MichaelBentleyOh/RCS_2023_winter_project/modeling/stl/Arm_Upper(15).stl

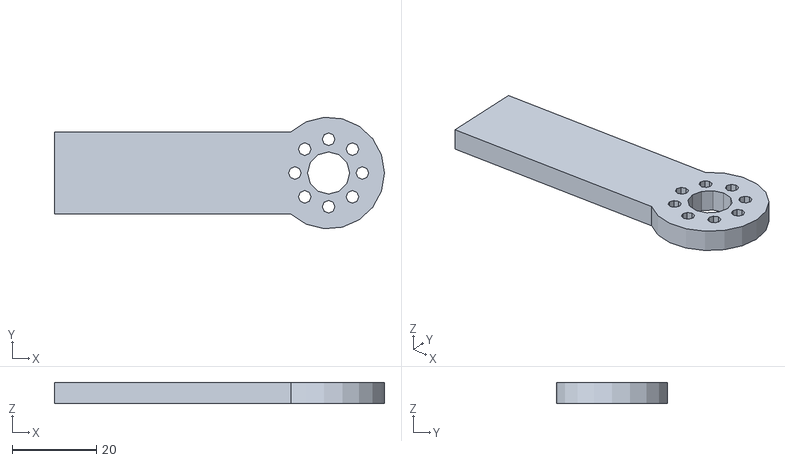
[picture p42: CAD file, 2024-02-15]
modeling/stl/Arm_Upper(15).stl
78.2 x 26.4 x 5.00
