MichaelBentleyOh/RCS_2023_winter_project/modeling/stl/Cap(20).stl

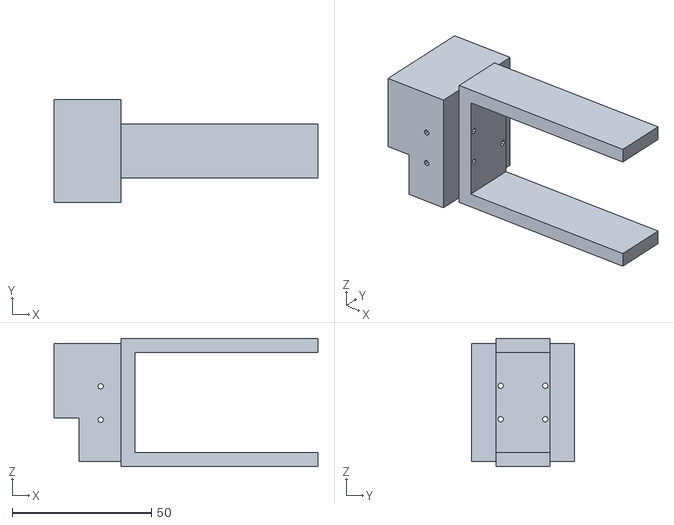
[picture p43: CAD file, 2024-02-15]
modeling/stl/Cap(20).stl
94.8 x 36.9 x 46.0
