MichaelBentleyOh/RCS_2023_winter_project/modeling/stl/2ND_TIGHT.stl

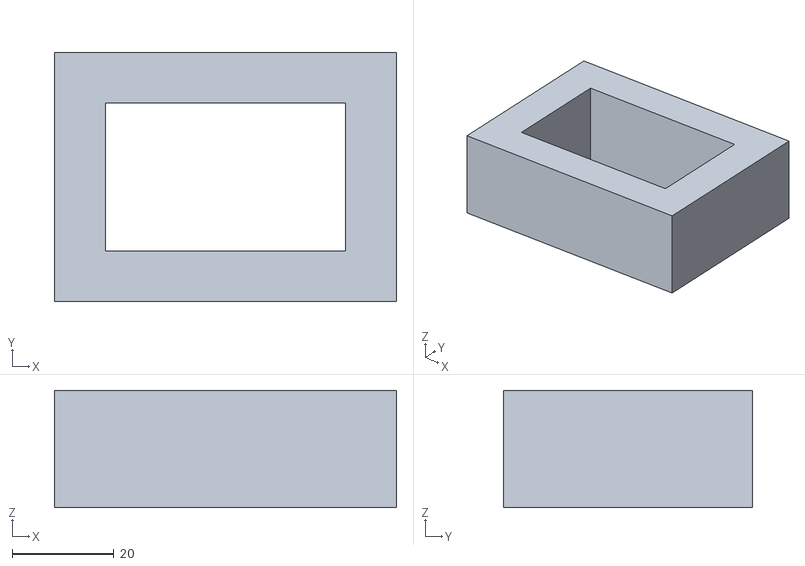
[picture p44: CAD file, 2024-02-15]
modeling/stl/2ND_TIGHT.stl
67.2 x 49.0 x 23.0
