MichaelBentleyOh/RCS_2023_winter_project/modeling/stl/2ND_SHORT_POLE(M2)X2.stl

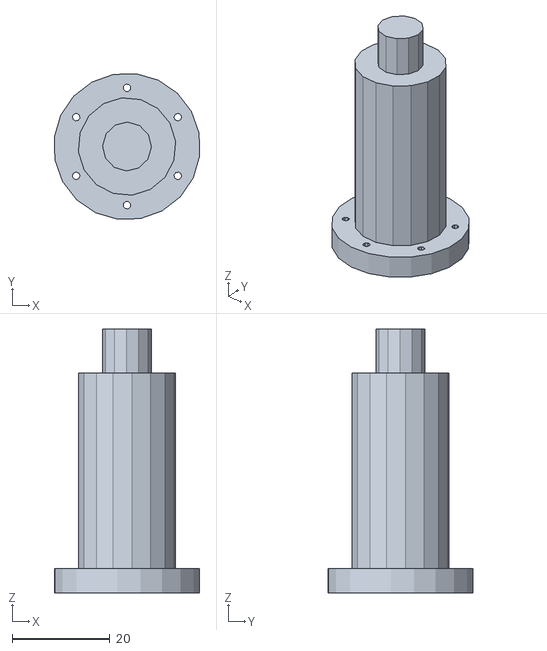
[picture p45: CAD file, 2024-02-15]
modeling/stl/2ND_SHORT_POLE(M2)X2.stl
29.8 x 29.8 x 54.0
