MichaelBentleyOh/RCS_2023_winter_project/modeling/stl/Cap(15).stl

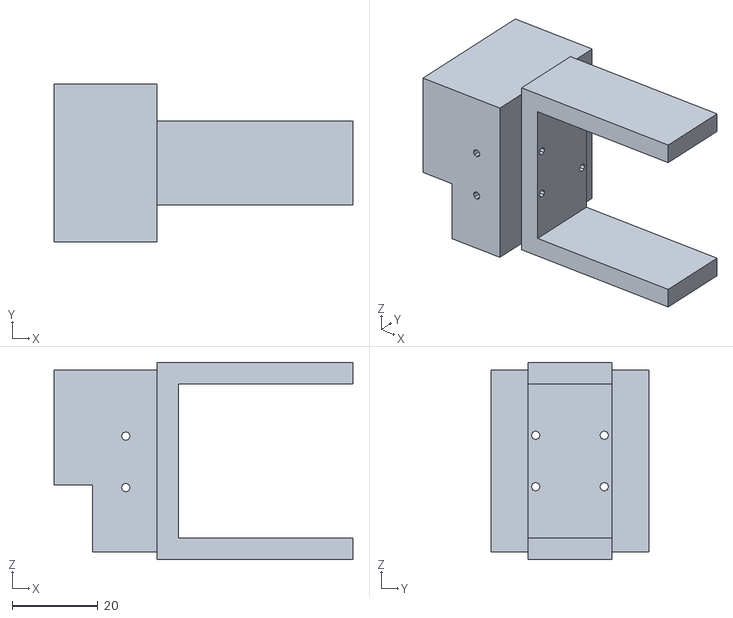
[picture p46: CAD file, 2024-02-15]
modeling/stl/Cap(15).stl
69.8 x 36.9 x 46.0
