MichaelBentleyOh/RCS_2023_winter_project/modeling/stl/2ND_LONG_POLE(M2).stl

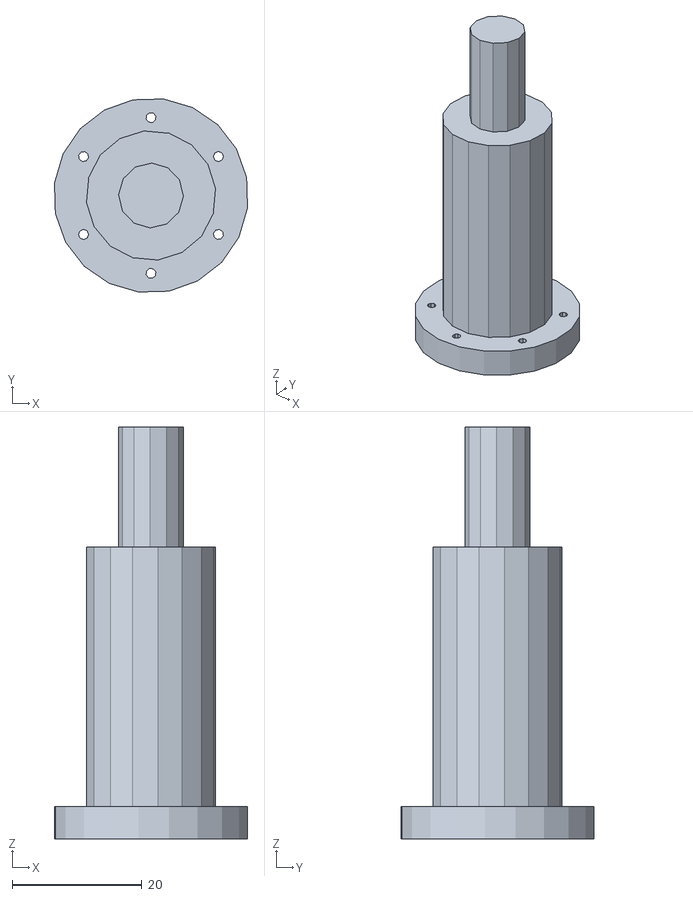
[picture p48: CAD file, 2024-02-15]
modeling/stl/2ND_LONG_POLE(M2).stl
29.8 x 29.8 x 63.5
