MichaelBentleyOh/RCS_2023_winter_project/modeling/stl/2ND_LOW(M2).stl

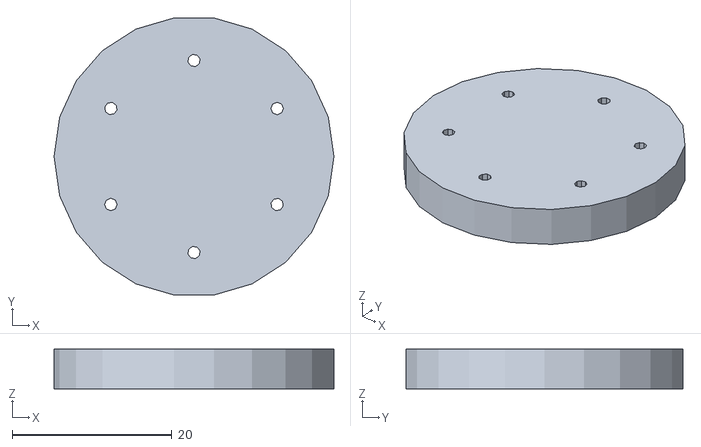
[picture p49: CAD file, 2024-02-15]
modeling/stl/2ND_LOW(M2).stl
35.0 x 34.6 x 5.00
