MichaelBentleyOh/RCS_2023_winter_project/modeling/stl/Motor_Lower_Part2.stl

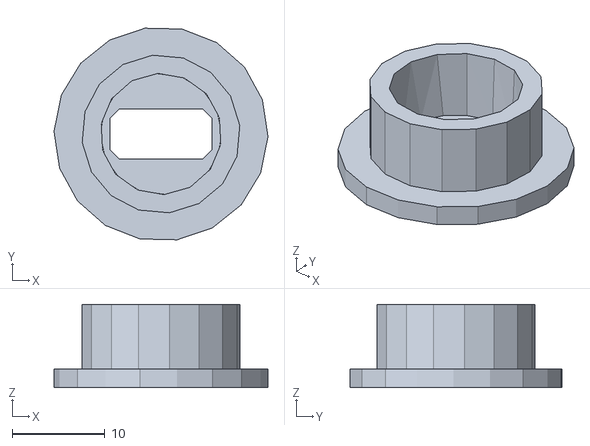
[picture p51: CAD file, 2024-02-15]
modeling/stl/Motor_Lower_Part2.stl
23.1 x 22.8 x 9.00
