MichaelBentleyOh/RCS_2023_winter_project/modeling/stl/2ND_UPPER.stl

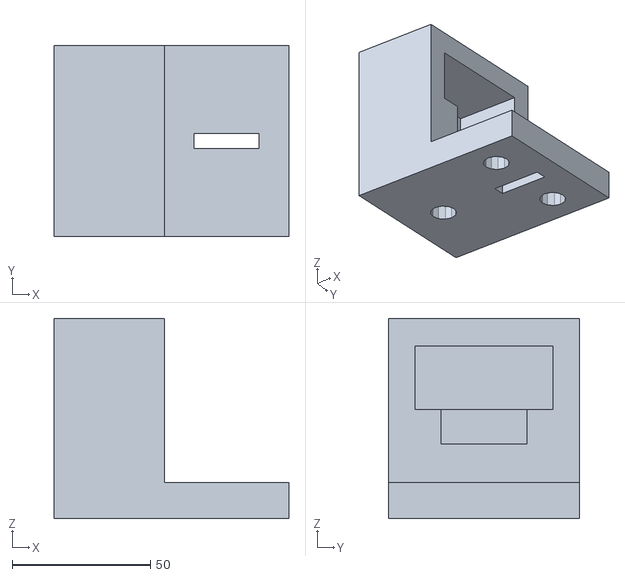
[picture p52: CAD file, 2024-02-15]
modeling/stl/2ND_UPPER.stl
85.0 x 69.0 x 72.4
