MichaelBentleyOh/RCS_2023_winter_project/modeling/stl/Gripper_AllCATPart.stl

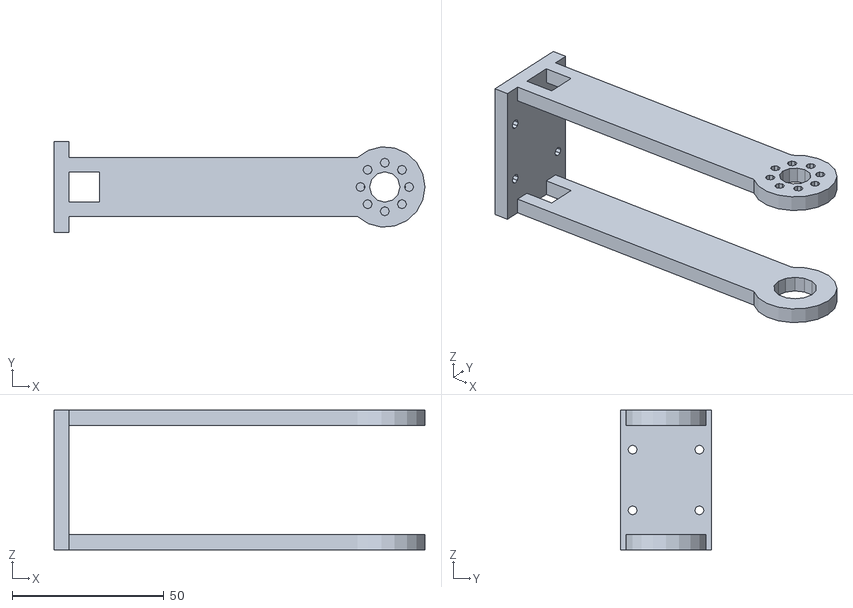
[picture p53: CAD file, 2024-02-15]
modeling/stl/Gripper_AllCATPart.stl
122.3 x 30.0 x 46.0
