MichaelBentleyOh/RCS_2023_winter_project/modeling/stl/Motor_Lower_Part1.stl

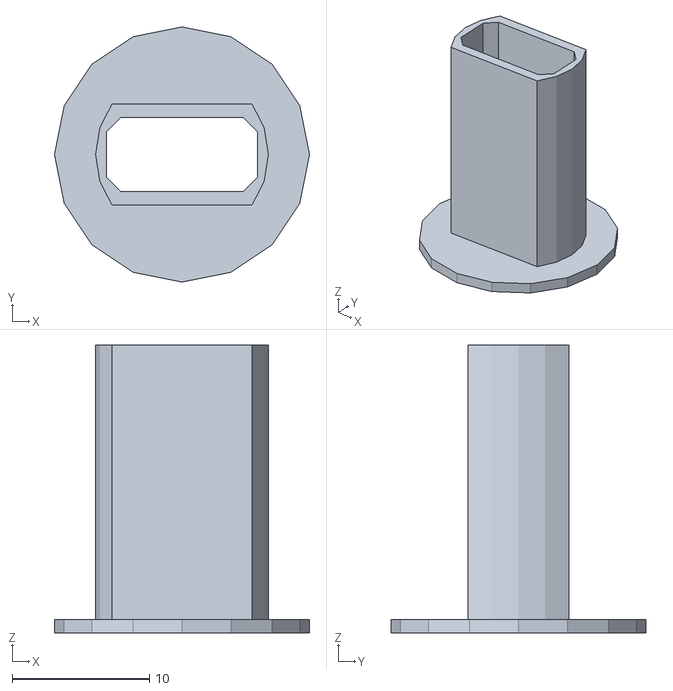
[picture p54: CAD file, 2024-02-15]
modeling/stl/Motor_Lower_Part1.stl
18.6 x 18.6 x 21.0
