MichaelBentleyOh/RCS_2023_winter_project/modeling/stl/link_connect.stl

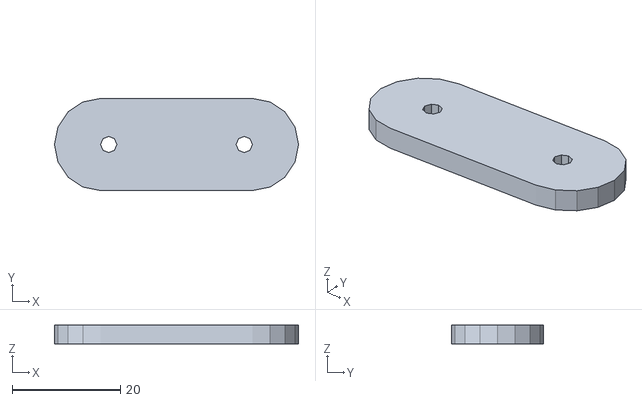
[picture p55: CAD file, 2024-02-15]
modeling/stl/link_connect.stl
45.0 x 17.0 x 3.50
