MichaelBentleyOh/RCS_2023_winter_project/modeling/stl/Arm_Upper(20).stl

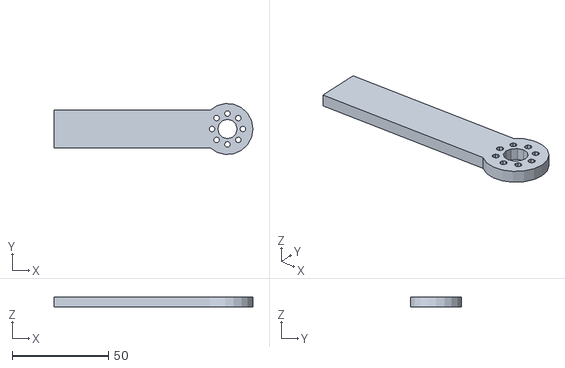
[picture p56: CAD file, 2024-02-15]
modeling/stl/Arm_Upper(20).stl
103.2 x 26.4 x 5.00
