MichaelBentleyOh/RCS_2023_winter_project/(list of files, cad)

Other CAD files:
modeling/stl/Assembly.stl
