MichaelBentleyOh/RCS_2023_winter_project/modeling/assembled.png

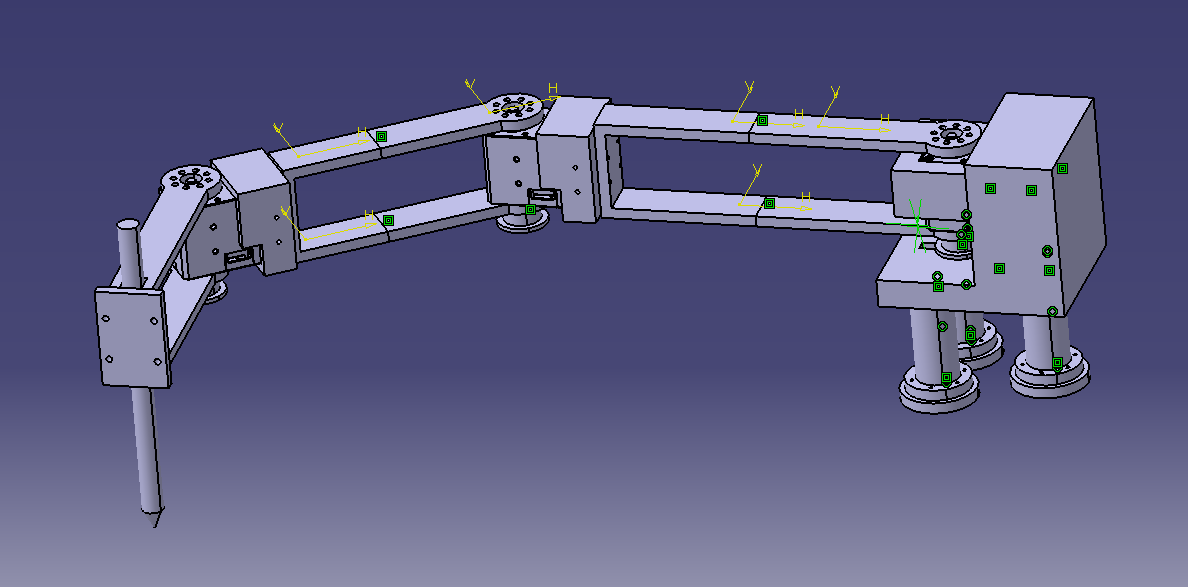
modeling/assembled.png
