MichaelBentleyOh/RCS_2023_winter_project/(commit log)

2024-02-15 Add modeling files (stl)
    [2ND_LONG_POLE(M2).stl, 2ND_LOW(M2).stl, 2ND_SHORT_POLE(M2)X2.stl, 2ND_TIGHT.stl, 2ND_UPPER.stl, Arm_Lower(15).stl, Arm_Lower(20).stl, Arm_Upper(15).stl]
2024-02-26 assembled parts(image) added
2024-02-26 assembled parts(stl) added
2024-02-27 Create stl
2024-02-27 Update and rename modeling/2ND_LONG_POLE(M2).stl to modeling/stl/2ND_LONG_POLE(M2).stl
    [2ND_LONG_POLE(M2).stl]
2024-02-27 Update and rename modeling/2ND_LOW(M2).stl to modeling/stl/2ND_LOW(M2).stl
    [2ND_LOW(M2).stl]
2024-02-27 Update and rename modeling/2ND_SHORT_POLE(M2)X2.stl to modeling/stl/2ND_SHORT_POLE(M2)X2.stl
    [2ND_SHORT_POLE(M2)X2.stl]
2024-02-27 Update and rename modeling/2ND_TIGHT.stl to modeling/stl/2ND_TIGHT.stl
    [2ND_TIGHT.stl]
2024-02-27 Update and rename modeling/2ND_UPPER.stl to modeling/stl/2ND_UPPER.stl
    [2ND_UPPER.stl]
2024-02-27 Update and rename modeling/Arm_Lower(15).stl to modeling/stl/Arm_Lower(15).stl
    [Arm_Lower(15).stl]
2024-02-27 Update and rename modeling/Arm_Lower(20).stl to modeling/stl/Arm_Lower(20).stl
    [Arm_Lower(20).stl]
2024-02-27 Update and rename modeling/Arm_Upper(15).stl to modeling/stl/Arm_Upper(15).stl
    [Arm_Upper(15).stl]
2024-02-27 Update and rename modeling/Arm_Upper(20).stl to modeling/stl/Arm_Upper(20).stl
    [Arm_Upper(20).stl]
2024-02-27 Update and rename modeling/Cap(15).stl to modeling/stl/Cap(15).stl
    [Cap(15).stl]
2024-02-27 Update and rename modeling/Cap(20).stl to modeling/stl/Cap(20).stl
    [Cap(20).stl]
2024-02-27 Update and rename modeling/Gripper_AllCATPart.stl to modeling/stl/Gripper_AllCATPart.stl
    [Gripper_AllCATPart.stl]
2024-02-27 Update and rename modeling/Motor_Lower_Part1.stl to modeling/stl/Motor_Lower_Part1.stl
    [Motor_Lower_Part1.stl]
2024-02-27 Update and rename modeling/Motor_Lower_Part2.stl to modeling/stl/Motor_Lower_Part2.stl
    [Motor_Lower_Part2.stl]
2024-02-27 Update and rename modeling/link_connect.stl to modeling/stl/link_connect.stl
    [link_connect.stl]
